thejbte/Gateway_CESE_2019/README.md

# Gateway_CESE_2019
T de G Especialización en sistemas embebidos- UBA-2019
