thejbte/Gateway_CESE_2019/Plantilla-CESE/memoria.tex

%%%%%%%%%%%%%%%%%%%%%%%%%%%%%%%%%%%%%%%%%
% Masters/Doctoral Thesis 
% LaTeX Template
% Version 2.3 (25/3/16)
%
% This template has been downloaded from:
% http://www.LaTeXTemplates.com
%
% Version 2.x major modifications by:
% Vel (vel@latextemplates.com)
%
% This template is based on a template by:
% Steve Gunn (http://users.ecs.soton.ac.uk/srg/softwaretools/document/templates/)
% Sunil Patel (http://www.sunilpatel.co.uk/thesis-template/)
%
% Template license:
% CC BY-NC-SA 3.0 (http://creativecommons.org/licenses/by-nc-sa/3.0/)
%
%%%%%%%%%%%%%%%%%%%%%%%%%%%%%%%%%%%%%%%%%

%----------------------------------------------------------------------------------------
%	PACKAGES AND OTHER DOCUMENT CONFIGURATIONS
%----------------------------------------------------------------------------------------
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

\usepackage{caption}
\usepackage{subcaption}

%------------------------
\usepackage{listings}

%\usepackage[hyphens]{url}
%\usepackage[hidelinks]{hyperref}
%\hypersetup{breaklinks=true}
\urlstyle{same}
%\usepackage{cite}

%--------------------------

\usepackage{color}

%
%----------------------------------------------------------------------------------------
%	MARGIN SETTINGS
%----------------------------------------------------------------------------------------

\geometry{
	paper=a4paper, % Change to letterpaper for US letter
	inner=2cm, % Inner margin
	outer=3.3cm, % Outer margin
	bindingoffset=2cm, % Binding offset
	top=1.5cm, % Top margin
	bottom=1.5cm, % Bottom margin
	%showframe,% show how the type block is set on the page
}

%----------------------------------------------------------------------------------------
%	INFORMACIÓN DE LA MEMORIA
%----------------------------------------------------------------------------------------

\thesistitle{Dispositivo logger IoT con tecnologías de comunicación Sigfox y Lora} % El títulos de la memoria, se usa en la carátula y se puede usar el cualquier lugar del documento con el comando \ttitle
\supervisor{Ing. Marcelo E. Romeo (UNSAM, UTN-FRBA)} % El nombre del director, se usa en la carátula y se puede usar el cualquier lugar del documento con el comando \supname
\degree{Especialista en Sistemas Embebidos } % Nombre del grado, se usa en la carátula y se puede usar el cualquier lugar del documento con el comando \degreename
\author{Ing. Julian Bustamante Narvaez} % Tu nombre, se usa en la carátula y se puede usar el cualquier lugar del documento con el comando \authorname
\juradoUNO{Esp. Ing. Leonardo Carducci (FIUBA)} % Nombre y pertenencia del un jurado se usa en la carátula y se puede usar el cualquier lugar del documento con el comando \jur1name
\juradoDOS{Esp. Ing. Agustin Bassi (FIUBA)} % Nombre y pertenencia del un jurado se usa en la carátula y se puede usar el cualquier lugar del documento con el comando \jur2name
\juradoTRES{Esp. Ing. Ramiro Alonso (FIUBA)} % Nombre y pertenencia del un jurado se usa en la carátula y se puede usar el cualquier lugar del documento con el comando \jur3name
\fechaINICIO{agosto de 2018}
\fechaFINAL{agosto de 2019}

\subject{Memoria del Trabajo Final de la Carrera de Especialización en Sistemas Embebidos de la UBA} % Your subject area, this is not currently used anywhere in the template, print it elsewhere with \subjectname
\keywords{CESE, Sistemas Embebidos, CIAA} % Keywords for your thesis, this is not currently used anywhere in the template, print it elsewhere with \keywordnames
\university{Universidad de Buenos Aires} % Your university's name and URL, this is used in the title page and abstract, print it elsewhere with \univname
\faculty{{Facultad de Ingeniería}} % Your faculty's name and URL, this is used in the title page and abstract, print it elsewhere with \facname
\department{Departamento de Electrónica} % Your department's name and URL, this is used in the title page and abstract, print it elsewhere with \deptname
\group{{Laboratorio de Sistemas Embebidos}} % Your research group's name and URL, this is used in the title page, print it elsewhere with \groupname

\hypersetup{pdftitle=\ttitle} % Set the PDF's title to your title
\hypersetup{pdfauthor=\authorname} % Set the PDF's author to your name
\hypersetup{pdfkeywords=\keywordnames} % Set the PDF's keywords to your keywords

\newcaptionname{spanish}{\acknowledgementname}{Agradecimientos}
\newcaptionname{spanish}{\authorshipname}{Declaración de Autoría}
\newcaptionname{spanish}{\abbrevname}{Glosario}
\newcaptionname{spanish}{\byname}{por}

\renewcommand{\lstlistingname}{Algoritmo}% Listing -> Algorithm
\renewcommand{\lstlistlistingname}{Índice de \lstlistingname s}% List of Listings -> List of Algorithms

\renewcommand{\listtablename}{Índice de Tablas}
\renewcommand{\tablename}{Tabla} 

\addtolength{\footnotesep}{2mm} % Espacio adicional en los footnotes

\begin{document}

\frontmatter % Use roman page numbering style (i, ii, iii, iv...) for the pre-content pages

\pagestyle{plain} % Default to the plain heading style until the thesis style is called for the body content

%----------------------------------------------------------------------------------------
%	CARÁTULA
%----------------------------------------------------------------------------------------

\begin{titlepage}
\begin{center}

{\scshape\LARGE UNIVERSIDAD DE BUENOS AIRES\par}\vspace{0.1cm} % University name
{\scshape\LARGE FACULTAD DE INGENIERÍA\par}\vspace{0.1cm} % Faculty name
{\scshape\LARGE Carrera de Especialización en Sistemas Embebidos\par}\vspace{1cm} % Thesis type

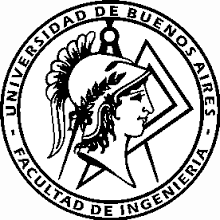
[picture p1: Plantilla-CESE/Figures/logoFIUBA.png]

\vspace{1cm}

\textsc{\Large Memoria del Trabajo Final}\\[0.5cm] % Thesis type

{\huge \bfseries \ttitle\par}\vspace{0.4cm} % Thesis title

\vspace{1cm}
\LARGE\textbf{Autor:\\
\authorname}\\ % Author name

\vspace{1cm}

\large
\vspace{10px}
{Director:} \\
{\supname} % Supervisor name
 
\vspace{1cm}
Jurados:\\
\jurunoname\\
\jurdosname\\
\jurtresname
 
\vfill
\textit{Este trabajo fue realizado en la Ciudad Autónoma de Buenos Aires, entre \fechaINICIOname \hspace{1px} y \fechaFINALname.}
\end{center}
\end{titlepage}

%----------------------------------------------------------------------------------------
%	RESUMEN - ABSTRACT 
%----------------------------------------------------------------------------------------

\begin{abstract}
\addchaptertocentry{\abstractname} % Add the abstract to the table of contents
%
%The Thesis Abstract is written here (and usually kept to just this page). The page is kept centered vertically so can expand into the blank space above the title too\ldots
\centering

En esta memoria se presenta el diseño e implementación de un dispositivo de adquisición de datos con múltiples entradas digitales y análogicas para aplicaciones IoT (\textit{Internet of Things}) en ambientes industriales
para la empresa Tecrea S.A.S. El dispositivo tiene una arquitectura modular que le permite incorporar nuevas funcionalidades y puede operar con protocolos
inalámbricos como SigFox o Lora.

Este proyecto se enfocó en que los procesos de toma de datos sean menos dependientes de las personas y se puedan auto gestionar con información
adquirida en tiempo real.
En el presente trabajo se plasman los conocimientos en el desarrollo de firmware en sistemas embebidos, 
testing de software, diseño electrónico, circuitos impresos y gestión de proyectos.

\end{abstract}

%----------------------------------------------------------------------------------------
%	CONTENIDO DE LA MEMORIA  - AGRADECIMIENTOS
%----------------------------------------------------------------------------------------

\begin{acknowledgements}
%\addchaptertocentry{\acknowledgementname} % Descomentando esta línea se puede agregar los agradecimientos al índice
\vspace{1.5cm}

A la mujer de mi vida, Adriana, por el sacrificio que hizo y la comprensión que tuvo en los momentos donde no tenía tiempo para ella.

A mi madre Edith, a mi padre Oscar y a mis hermanos, Lina, Jonatan, Felipe y Melissa por la ayuda imprescindible, por creer en mis expectativas y por comprender mis largas horas de trabajo y estudio. 

A Tecrea SAS por el tiempo y colaboración brindada y a cada uno de mis compañeros de trabajo por todas sus enseñanzas.

\end{acknowledgements}

%----------------------------------------------------------------------------------------
%	LISTA DE CONTENIDOS/FIGURAS/TABLAS
%----------------------------------------------------------------------------------------
\renewcommand{\listtablename}{Índice de Tablas}

\tableofcontents % Prints the main table of contents

\listoffigures % Prints the list of figures

\listoftables % Prints the list of tables

%----------------------------------------------------------------------------------------
%	CONTENIDO DE LA MEMORIA  - DEDICATORIA
%----------------------------------------------------------------------------------------

\dedicatory{\textbf{
Con paciencia, dedicación y perseverancia los sueños se pueden cumplir.
Este trabajo se lo dedico a toda familia, ellos son el motor de mis sueños. }}  % escribir acá si se desea una dedicatoria

%----------------------------------------------------------------------------------------
%	CONTENIDO DE LA MEMORIA  - CAPÍTULOS
%----------------------------------------------------------------------------------------

\mainmatter % Begin numeric (1,2,3...) page numbering

\pagestyle{thesis} % Return the page headers back to the "thesis" style

\renewcommand{\tablename}{Tabla} 

% Incluir los capítulos como archivos separados desde la carpeta Chapters
% Descomentar las líneas a medida que se escriben los capítulos

\input{Chapters/Chapter1}
\input{Chapters/Chapter2} 
\input{Chapters/Chapter3}
\input{Chapters/Chapter4} 
\input{Chapters/Chapter5} 

%----------------------------------------------------------------------------------------
%	CONTENIDO DE LA MEMORIA  - APÉNDICES
%----------------------------------------------------------------------------------------

\appendix % indicativo para indicarle a LaTeX los siguientes "capítulos" son apéndices

% Incluir los apéndices de la memoria como archivos separadas desde la carpeta Appendices
% Descomentar las líneas a medida que se escriben los apéndices

%\input{Appendices/AppendixA}
%\input{Appendices/AppendixB}
%\input{Appendices/AppendixC}

%----------------------------------------------------------------------------------------
%	BIBLIOGRAPHY
%----------------------------------------------------------------------------------------

\Urlmuskip=0mu plus 1mu\relax
\raggedright
\printbibliography[heading=bibintoc]

%----------------------------------------------------------------------------------------

\end{document}
