thejbte/Gateway_CESE_2019/Plantilla-CESE/Figures/DarginoDataLora.PNG

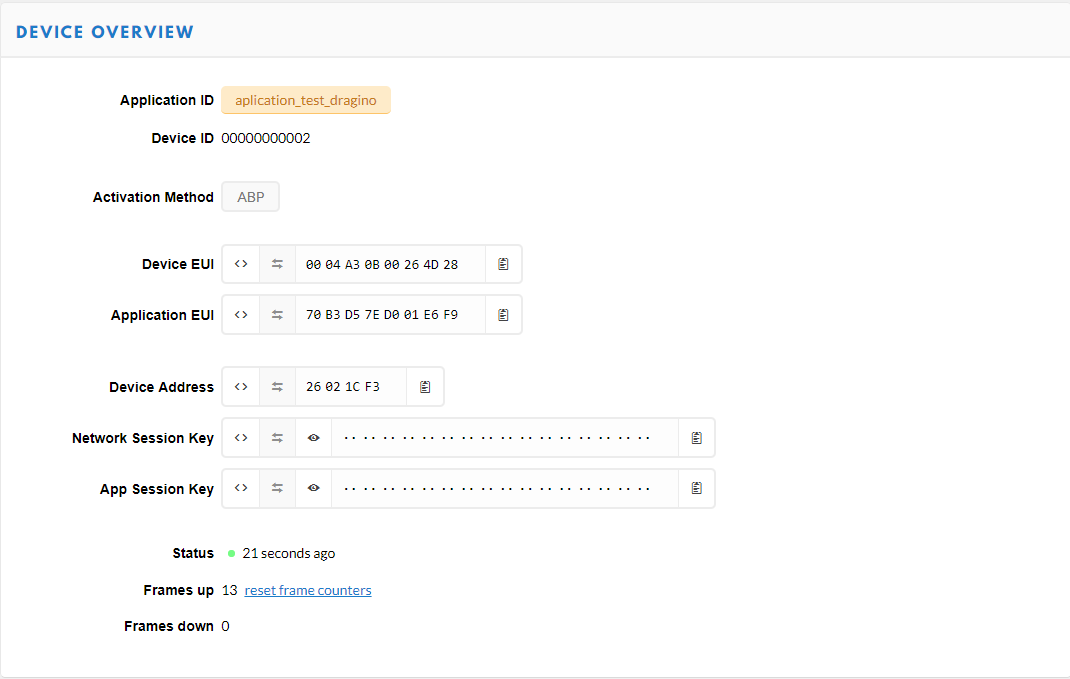
Plantilla-CESE/Figures/DarginoDataLora.PNG
