thejbte/Gateway_CESE_2019/Plantilla-CESE/Figures/esquemaGeneral2.png

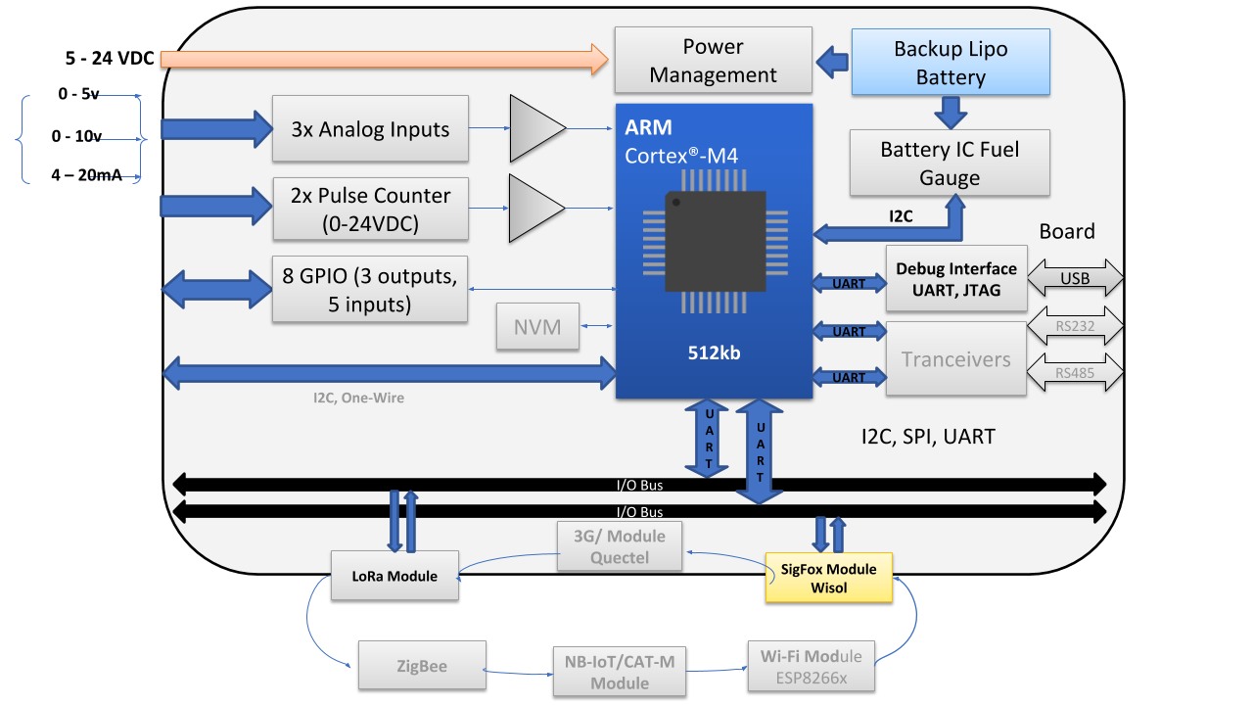
Plantilla-CESE/Figures/esquemaGeneral2.png
