thejbte/Gateway_CESE_2019/Plantilla-CESE/Figures/gsm1.jpeg

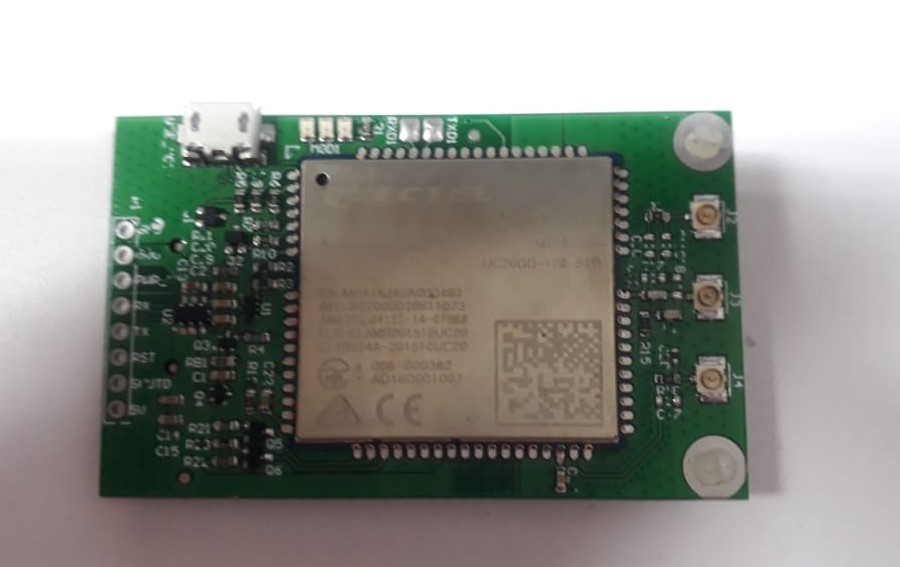
Plantilla-CESE/Figures/gsm1.jpeg
