thejbte/Gateway_CESE_2019/Plantilla-CESE/Figures/gsm.jpeg

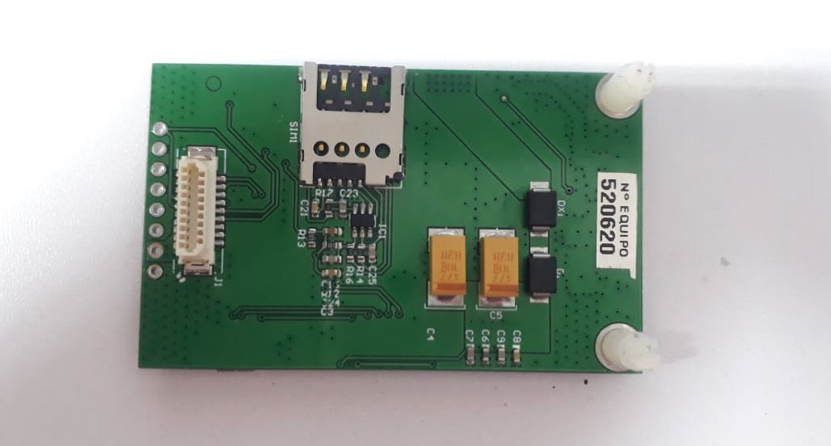
Plantilla-CESE/Figures/gsm.jpeg
