thejbte/Gateway_CESE_2019/Plantilla-CESE/Figures/Hierarchy.jpg

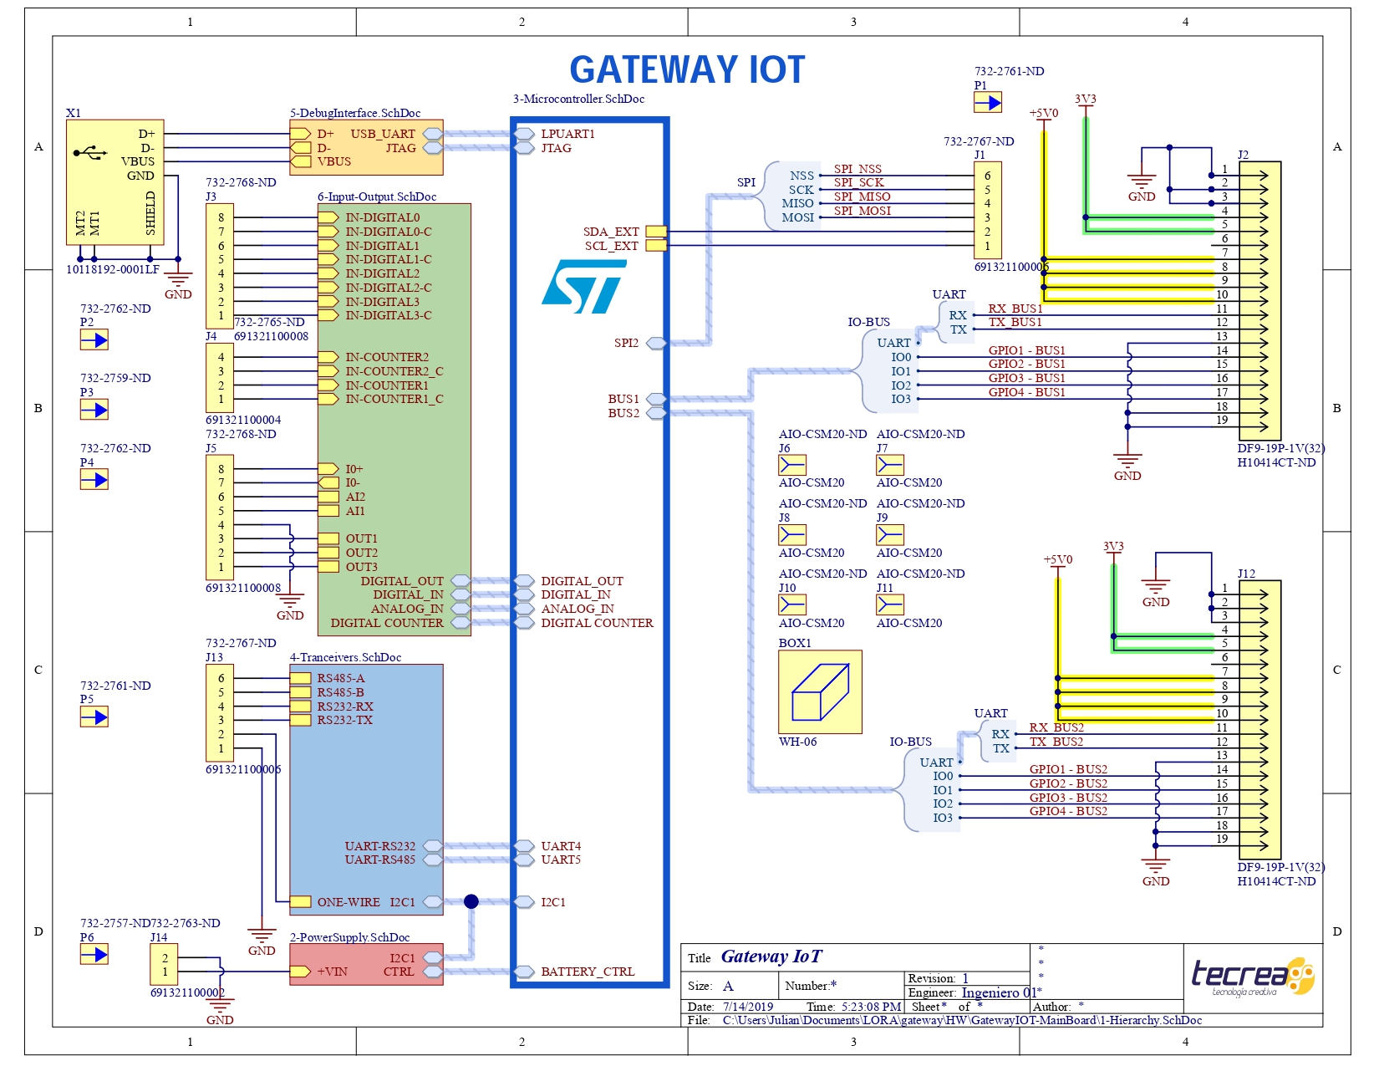
Plantilla-CESE/Figures/Hierarchy.jpg
