thejbte/Gateway_CESE_2019/Plantilla-CESE/Figures/InscripciónSigfox2.PNG

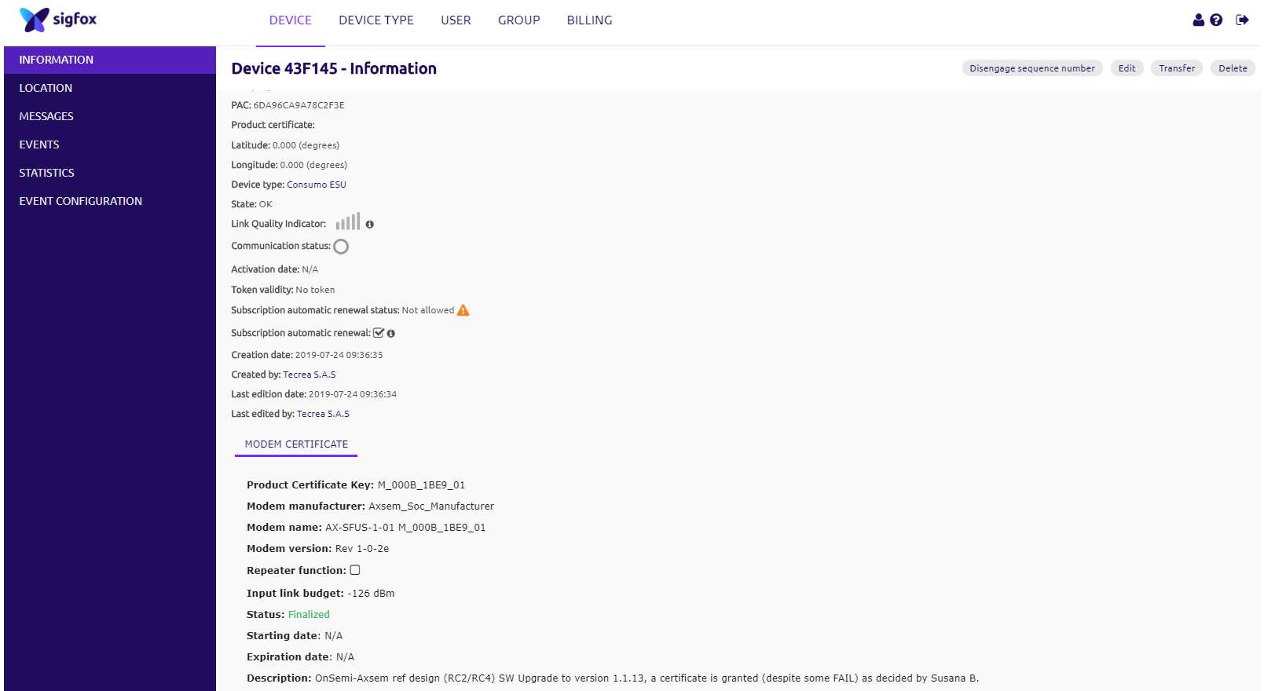
Plantilla-CESE/Figures/InscripciónSigfox2.PNG
