thejbte/Gateway_CESE_2019/Plantilla-CESE/Figures/InscripciónSigfox.PNG

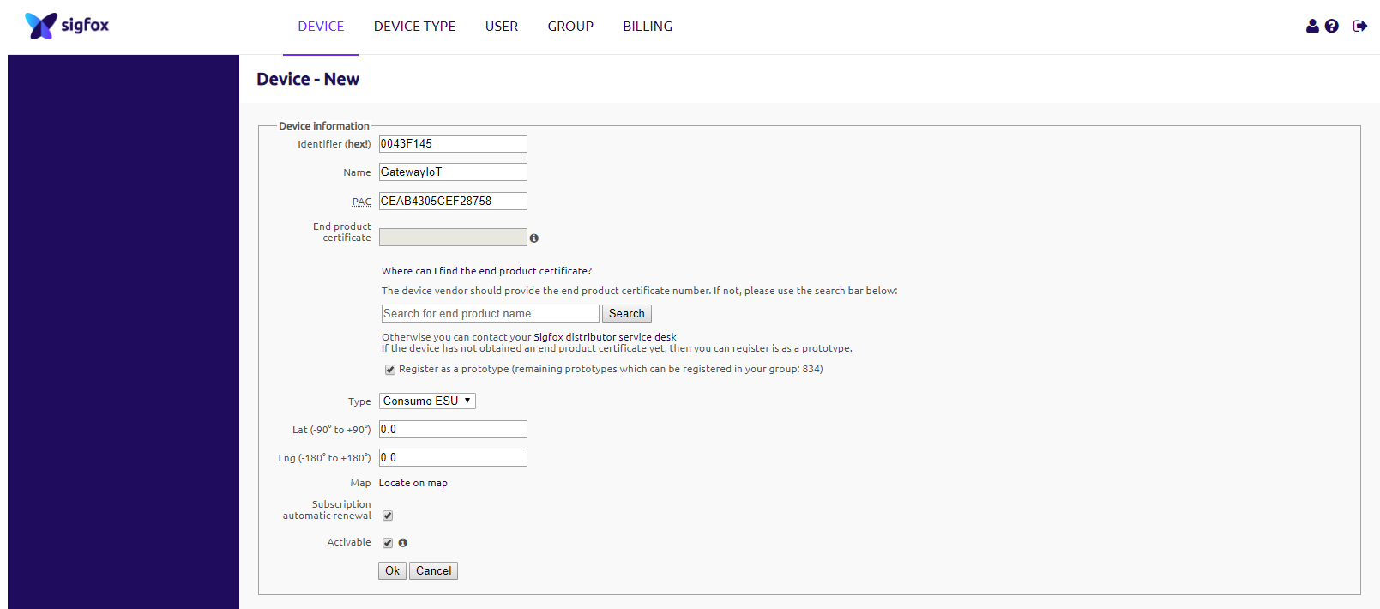
Plantilla-CESE/Figures/InscripciónSigfox.PNG
