thejbte/Gateway_CESE_2019/Plantilla-CESE/Figures/IntegracionSL.PNG

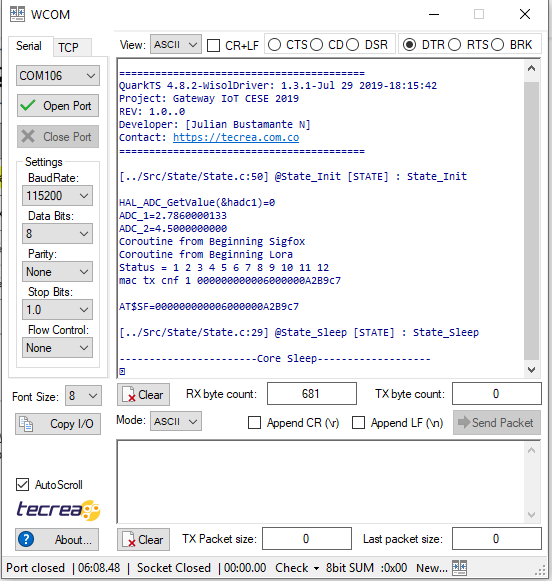
Plantilla-CESE/Figures/IntegracionSL.PNG
