thejbte/Gateway_CESE_2019/Plantilla-CESE/Figures/LoraClasses.PNG

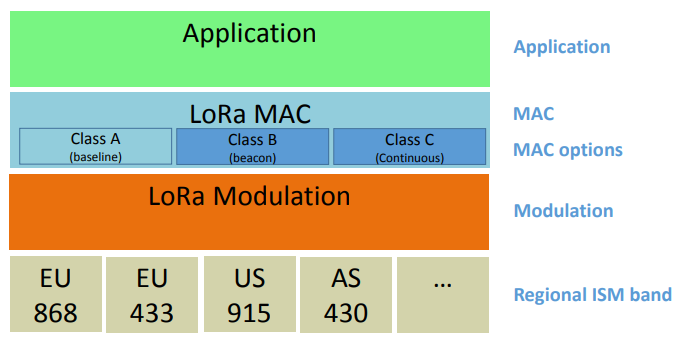
Plantilla-CESE/Figures/LoraClasses.PNG
