thejbte/Gateway_CESE_2019/Plantilla-CESE/Figures/LoraTXgrande.PNG

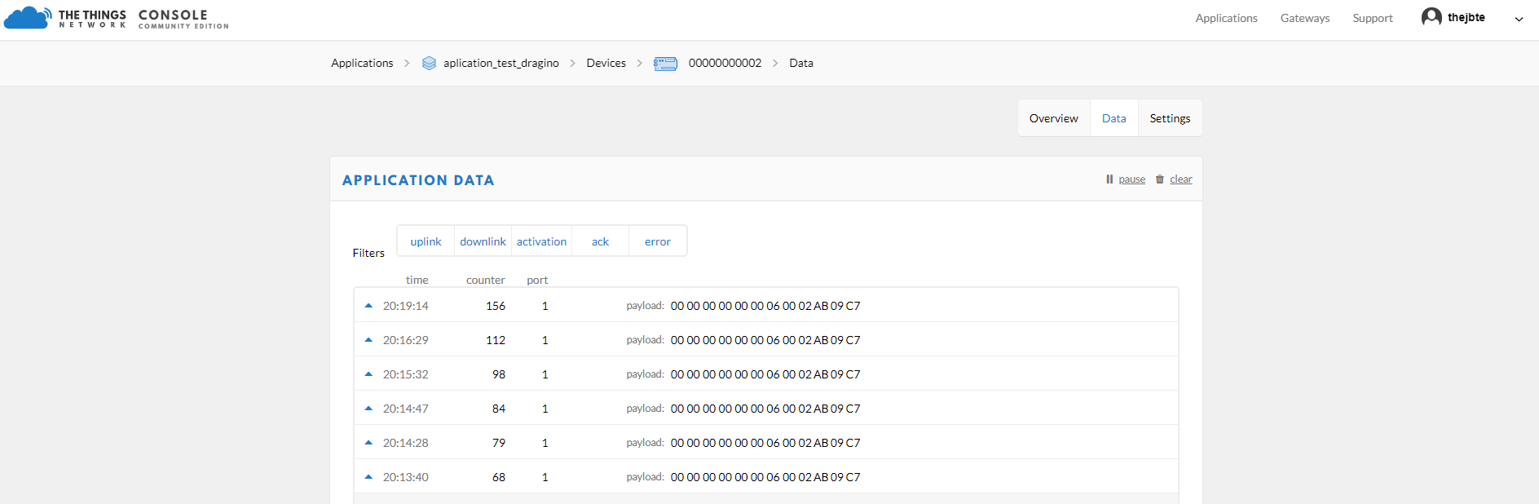
Plantilla-CESE/Figures/LoraTXgrande.PNG
