thejbte/Gateway_CESE_2019/Plantilla-CESE/Figures/MainBoard.jpeg

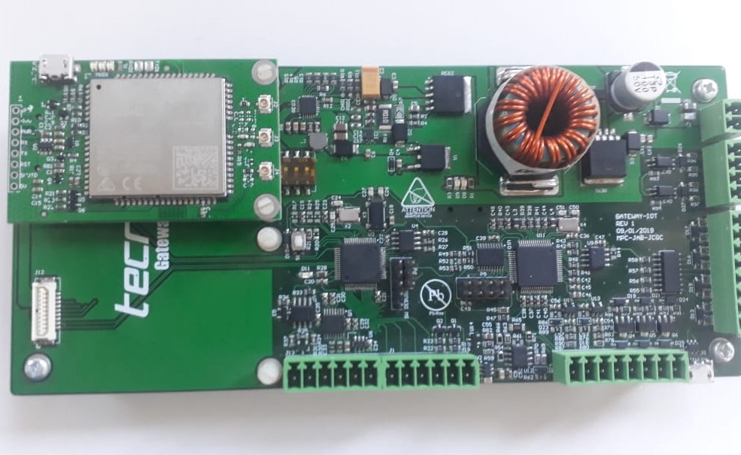
Plantilla-CESE/Figures/MainBoard.jpeg
