thejbte/Gateway_CESE_2019/Plantilla-CESE/Figures/RL_reflejada.PNG

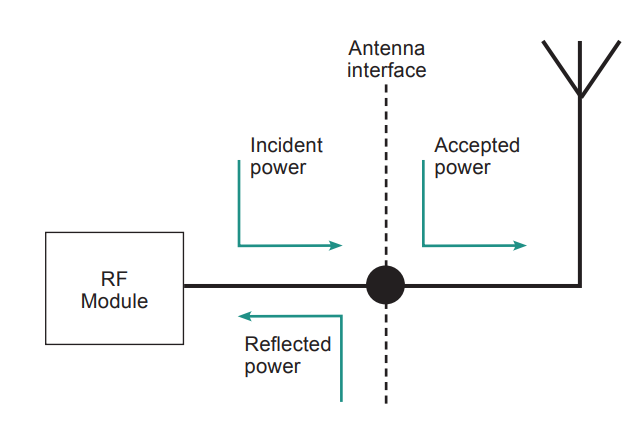
Plantilla-CESE/Figures/RL_reflejada.PNG
