thejbte/Gateway_CESE_2019/Plantilla-CESE/Figures/tunnigsigfoxGatewy_Bien_2.PNG

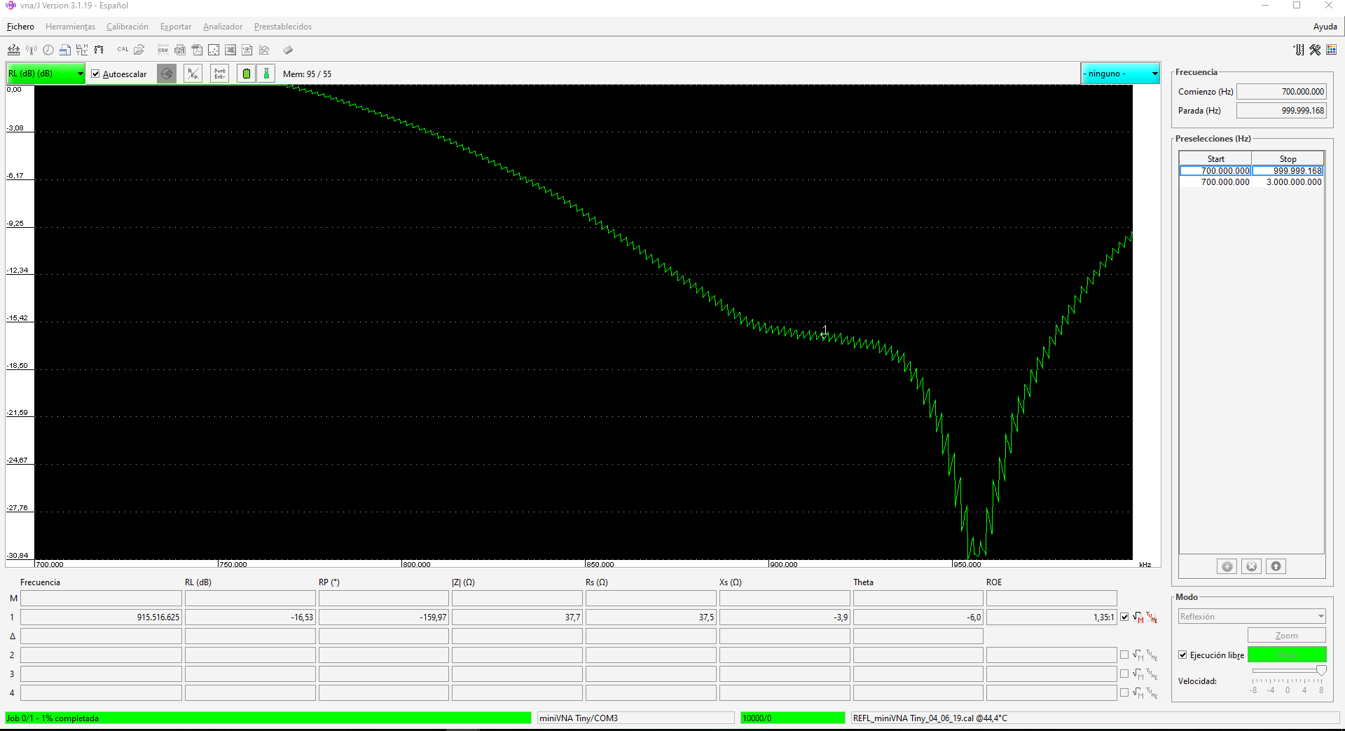
Plantilla-CESE/Figures/tunnigsigfoxGatewy_Bien_2.PNG
