thejbte/Gateway_CESE_2019/Gateway_prueba_prog/Gateway_prueba_prog.txt

Configuration	Gateway_prueba_prog
STM32CubeMX 	5.2.1
Date	07/28/2019
MCU	STM32L471RGTx

PERIPHERALS	MODES	FUNCTIONS	PINS
ADC1	IN4 Single-ended	ADC1_IN4	PC3
LPUART1	Asynchronous	LPUART1_RX	PB10
LPUART1	Asynchronous	LPUART1_TX	PC1
RTC	Activate RTC Clock Source	RTC_VS_RTC_Activate	VP_RTC_VS_RTC_Activate
RTC	Internal WakeUp	RTC_VS_RTC_WakeUp_intern	VP_RTC_VS_RTC_WakeUp_intern
SYS	SysTick	SYS_VS_Systick	VP_SYS_VS_Systick
USART2	Asynchronous	USART2_RX	PA3
USART2	Asynchronous	USART2_TX	PA2
USART3	Asynchronous	USART3_RX	PC5
USART3	Asynchronous	USART3_TX	PC4

Pin Nb	PINs	FUNCTIONs	LABELs
9	PC1	LPUART1_TX	
11	PC3	ADC1_IN4	
16	PA2	USART2_TX	
17	PA3	USART2_RX	
24	PC4	USART3_TX	
25	PC5	USART3_RX	
28	PB2	GPIO_Output	
29	PB10	LPUART1_RX	
37	PC6	GPIO_Output	Gpio4_Bus1_Shutdown
39	PC8	GPIO_Output	
40	PC9	GPIO_Output	Sigfox_Rst
51	PC10	GPIO_Output	Sigfox_shutdown
58	PB6	GPIO_Output	Gpio2_Bus1_Wakeup
62	PB9	GPIO_Output	Gpio3_Bus1_Rst
PERIPHERALS	MODES	FUNCTIONS	PINS
ADC1	IN4 Single-ended	ADC1_IN4	PC3
LPUART1	Asynchronous	LPUART1_RX	PB10
LPUART1	Asynchronous	LPUART1_TX	PC1
RTC	Activate RTC Clock Source	RTC_VS_RTC_Activate	VP_RTC_VS_RTC_Activate
RTC	Internal WakeUp	RTC_VS_RTC_WakeUp_intern	VP_RTC_VS_RTC_WakeUp_intern
SYS	SysTick	SYS_VS_Systick	VP_SYS_VS_Systick
USART2	Asynchronous	USART2_RX	PA3
USART2	Asynchronous	USART2_TX	PA2
USART3	Asynchronous	USART3_RX	PC5
USART3	Asynchronous	USART3_TX	PC4

Pin Nb	PINs	FUNCTIONs	LABELs
9	PC1	LPUART1_TX	
11	PC3	ADC1_IN4	
16	PA2	USART2_TX	
17	PA3	USART2_RX	
24	PC4	USART3_TX	
25	PC5	USART3_RX	
28	PB2	GPIO_Output	
29	PB10	LPUART1_RX	
37	PC6	GPIO_Output	Gpio4_Bus1_Shutdown
39	PC8	GPIO_Output	
40	PC9	GPIO_Output	Sigfox_Rst
51	PC10	GPIO_Output	Sigfox_shutdown
58	PB6	GPIO_Output	Gpio2_Bus1_Wakeup
62	PB9	GPIO_Output	Gpio3_Bus1_Rst

SOFTWARE PROJECT

Project Settings : 
Project Name : Gateway_prueba_prog
Project Folder : C:\Users\Julian\Desktop\TdeG_CESE\Gateway_CESE_2019\Gateway_prueba_prog
Toolchain / IDE : STM32CubeIDE
Firmware Package Name and Version : STM32Cube FW_L4 V1.14.0

Code Generation Settings : 
STM32Cube Firmware Library Package : Copy only the necessary library files
Generate peripheral initialization as a pair of '.c/.h' files per peripheral : No
Backup previously generated files when re-generating : No
Delete previously generated files when not re-generated : Yes
Set all free pins as analog (to optimize the power consumption) : No

Toolchains Settings : 
Compiler Optimizations :
