thejbte/Gateway_CESE_2019/Gateway_prueba_prog/Src/main.c

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

/* Includes ------------------------------------------------------------------*/
#include "main.h"

/* USER CODE BEGIN Includes */
#include <string.h>
#include "Common/Globals.h"
/* USER CODE END Includes */

ADC_HandleTypeDef hadc1;

UART_HandleTypeDef hlpuart1;
UART_HandleTypeDef huart2;
UART_HandleTypeDef huart3;

RTC_HandleTypeDef hrtc;

/* USER CODE BEGIN PV */
void PutCharWrapperLpUart_1(void *sp, const char c);
void PutStringWrapperLpUart_1(void *sp, const char *s);
/* USER CODE END PV */

void SystemClock_Config(void);
static void MX_GPIO_Init(void);
static void MX_LPUART1_UART_Init(void);
static void MX_USART3_UART_Init(void);
static void MX_USART2_UART_Init(void);
static void MX_ADC1_Init(void);
static void MX_RTC_Init(void);
/**
  * @brief  The application entry point.
  * @retval int
  */
int main(void)
{
  

  /* MCU Configuration--------------------------------------------------------*/

  /* Reset of all peripherals, Initializes the Flash interface and the Systick. */
  HAL_Init();

  /* Configure the system clock */
  SystemClock_Config();

  /* Initialize all configured peripherals */
  MX_GPIO_Init();
  MX_LPUART1_UART_Init();
  MX_USART3_UART_Init();
  MX_USART2_UART_Init();
  MX_ADC1_Init();
  MX_RTC_Init();
  /* USER CODE BEGIN 2 */

	HAL_UART_Receive_IT(&huart2,(uint8_t *)&UART_RX.Data,USART_RX_AMOUNT_BYTES);
	HAL_UART_Receive_IT(&huart3,(uint8_t *)&UART_RX3.Data,USART_RX_AMOUNT_BYTES);
	SigfoxModule.StatusFlag = WSSFM1XRX_Init(&SigfoxModule, RSTCtrl_Sigfox,
			RST2Ctrl_Sigfox, PutCharWrapperUart_1,
			WSSFM1XRX_RCZ4, DiscrimateFrameType, HAL_GetTick,BufferRxFrame,
			sizeof(BufferRxFrame), 4);
	SigFoxData.ReadyToUplink = 0;

	SigFoxData.ReadyToUplink = 0;
	SigFoxData.WilsolService_Status = WSSFM1XRX_STATUS_MODULE_NOT_INITIALIZED;

	qSetDebugFcn(UART_DEBUG);
	//HAL_PWR_EnableWakeUpPin(PWR_WAKEUP_PIN1); // quitar
	qResponseInitialize(&ResponseObject);
	//qResponseInitialize(&ResponseObjectLora);

	ProjectInformation();
	get_system_reset_cause();
	qSchedulerSetup(HAL_GetTick, 0.001, IdleTask_Callback, 0);

	qEdgeCheck_Initialize(&InputCheck, QREG_32BIT, 100);
	qEdgeCheck_InsertNode(&InputCheck, &InputButton, GPIOB_BASE, 0);

	qQueueCreate(&SigFox_UplinkQueue, mQueue_Stack, sizeof(SigfoxServiceRequest_t), 2);
	qTaskSetState(&Task_Wisol_Service,qEnabled);

	qSchedulerAddSMTask(&Task_ApplicationFSM, MEDIUM_Priority, 0.01, &StateMachine_ApplicationFSM, State_Init,NULL, NULL, State_Failure, NULL, qEnabled, NULL);
	qSchedulerAddxTask(&Task_Wisol_Service, WisolService_Callback, MEDIUM_Priority, 0.1, qPeriodic, qEnabled, NULL); /*en el mismo tiempo de la maquina de estados se pega en ATRC?? corutina??*/
	//qSchedulerAddxTask(&Task_LoRaWANService, LoRaWANService_Callback, MEDIUM_Priority, 0.1, qPeriodic, qDisabled, NULL); /*en el mismo tiempo de la maquina de estados se pega en ATRC?? corutina??*/

	qSchedulerAdd_EventTask(&Task_UplinkDispatcher, UplinkDispatcher_Callback, qHigh_Priority, NULL);
	qTaskAttachQueue(&Task_UplinkDispatcher, &SigFox_UplinkQueue, qQUEUE_COUNT, 1);

	qSchedulerRun();
  /* USER CODE END 2 */

  /* Infinite loop */
  /* USER CODE BEGIN WHILE */

  while (1)
  {
    /* USER CODE END WHILE */

    /* USER CODE BEGIN 3 */
	  //AN_IN1= ADC123_IN3(CORRIENTE)  AN_IN2 = ADC123_IN4(0-10) AN_IN3 = ADC12_IN9(0-5)
//	  value1 = App_ADCReadSingleChanne(&hadc1, 3);
//	  value2 = App_ADCReadSingleChanne(&hadc1, 4);
//	  value3 = App_ADCReadSingleChanne(&hadc1, 9);
//		// sprintf(buffer,"ADC_Current %d ADC_0_10 %d ADC_0_5 %d\r\n",value1 ,value2 ,value3 );
//		qTraceDecimal(value1);
//		qTraceDecimal(value2);
//		qTraceDecimal(value3);
//
//	  qTraceFloat(App_ADCReadSingleChanne(&hadc1, 3)*3.3/4095.0);
//		qTraceFloat(value2*3.3/4095.0);
//		qTraceFloat(value3*3.3/4095.0);

  }


  /* USER CODE END 3 */
}

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
/* USER CODE BEGIN 4 */


void HAL_RTCEx_WakeUpTimerEventCallback(RTC_HandleTypeDef *hrtc){
	PutStringWrapperUart_2(NULL,"=========================================\r\n");
	PutStringWrapperUart_2(NULL, "Wakeup Time\r\n");
	PutStringWrapperUart_2(NULL,"=========================================\r\n");
}
/* USER CODE END 4 */
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
