thejbte/Gateway_CESE_2019/Gateway_prueba_prog/Gateway_prueba_prog.ioc

Mcu.UserName=STM32L471RGTx
PA10.GPIO_Label=IN1
PA10.Signal=GPIO_Input
PA11.GPIO_Label=IN2
PA11.Signal=GPIO_Input
PA12.GPIO_Label=IN3
PA12.Signal=GPIO_Input
PA2.Signal=USART2_TX
PA3.Signal=USART2_RX
PA4.Signal=ADCx_IN9
PB0.GPIO_Label=IN4
PB0.Signal=GPIO_Input
PB10.Signal=LPUART1_RX
PB2.Signal=GPIO_Output
PB6.GPIO_Label=Gpio2_Bus1_Wakeup
PB6.Signal=GPIO_Output
PB9.GPIO_Label=Gpio3_Bus1_Rst
PB9.Signal=GPIO_Output
PC1.Signal=LPUART1_TX
PC10.GPIO_Label=Sigfox_shutdown
PC10.Signal=GPIO_Output
PC2.Signal=ADCx_IN3
PC3.Signal=ADCx_IN4
PC4.Signal=USART3_TX
PC5.Signal=USART3_RX
PC6.GPIO_Label=Gpio4_Bus1_Shutdown
PC6.Signal=GPIO_Output
PC8.Signal=GPIO_Output
PC9.GPIO_Label=Sigfox_Rst
PC9.Signal=GPIO_Output
