thejbte/Gateway_CESE_2019/(commit log)

2019-07-02 se agrega titulos hasta sección 2, no se quita nada de la plantilla aún
2019-07-12 Se agregan correciones de Ariel, se agregan referencias
2019-07-14 Se agrega toda la información de Sigfox al cap 2
2019-07-16 Se agrega ajustes al cap1, ajustes de imagenes y referencias cap1 y cap2,cap3
2019-08-12 Se agrega fw frame, ADC 0,1,2 pendiente austar ganancia y medición de corriente.
